MatthewBeddows/COSI-Electronics/Casing/Images/3D view.bmp

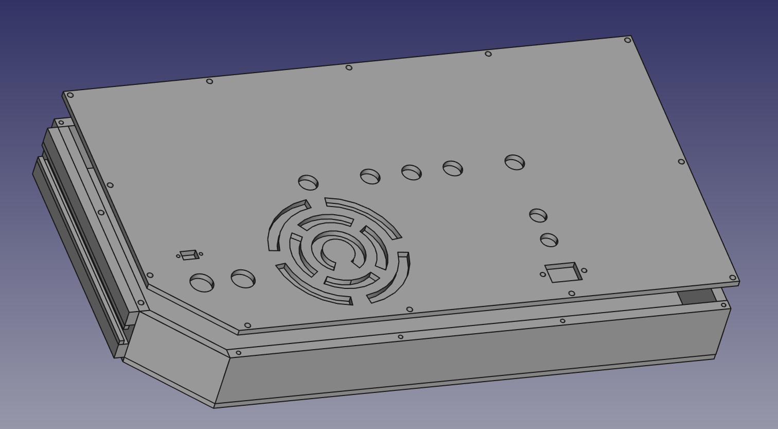
Casing/Images/3D view.bmp
