MatthewBeddows/COSI-Electronics/Casing/Images/back.bmp

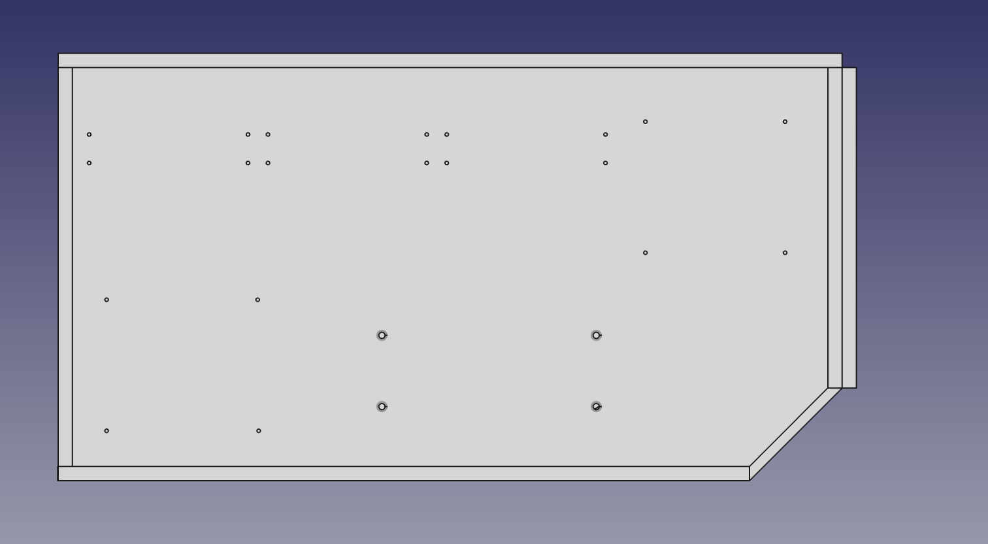
Casing/Images/back.bmp
