MatthewBeddows/COSI-Electronics/Casing/Images/bottom.bmp

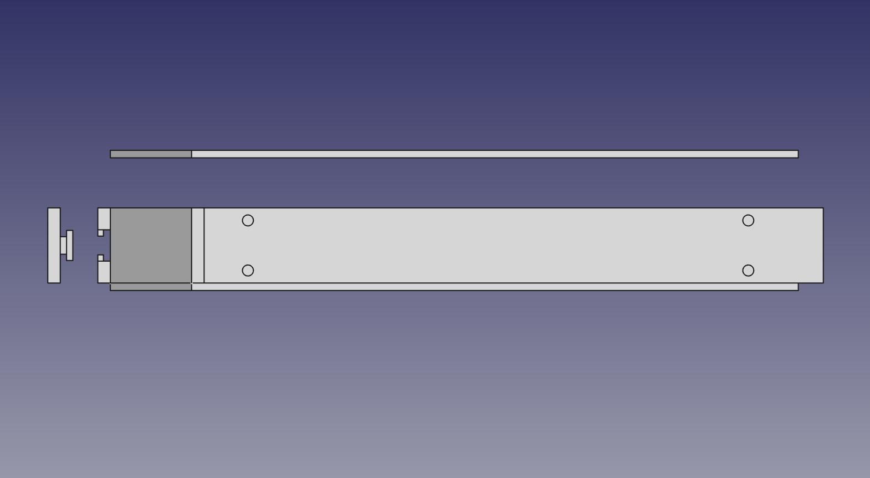
Casing/Images/bottom.bmp
