MatthewBeddows/COSI-Electronics/Casing/Images/front.bmp

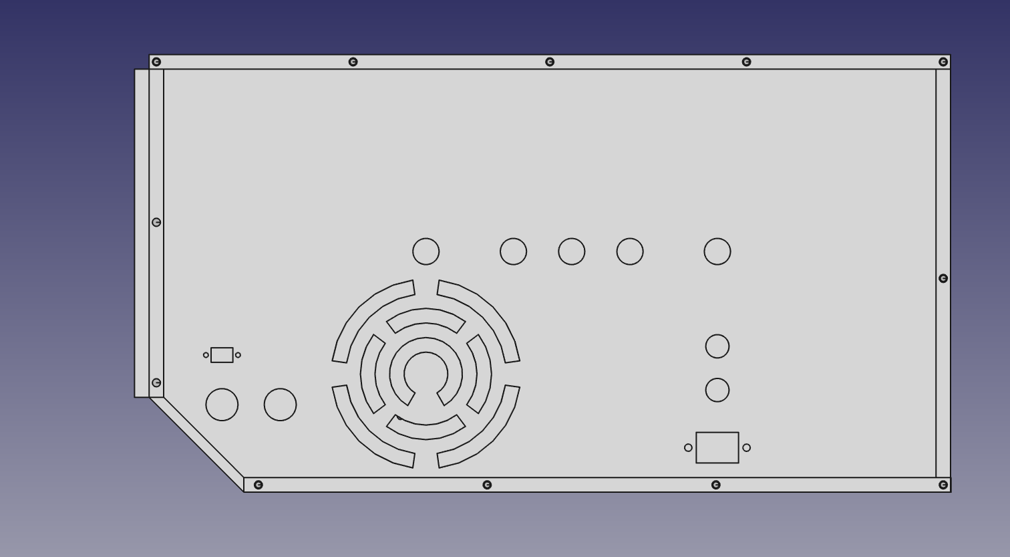
Casing/Images/front.bmp
