MatthewBeddows/COSI-Electronics/Casing/Images/front_noCover.bmp

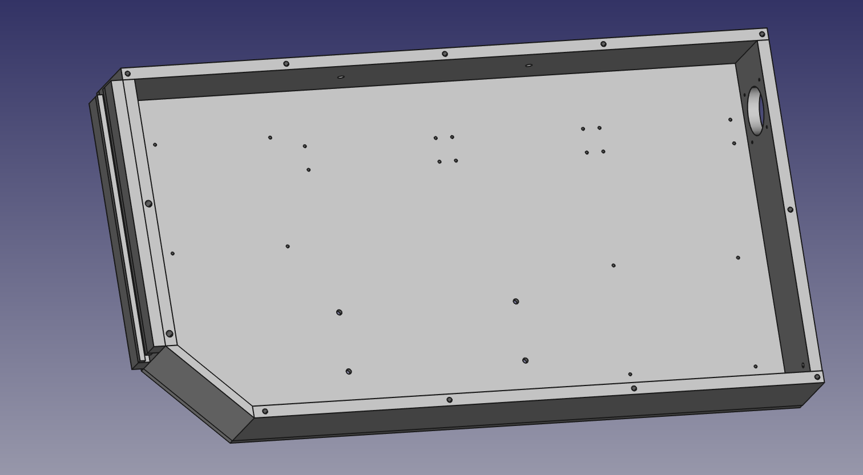
Casing/Images/front_noCover.bmp
