MatthewBeddows/COSI-Electronics/Casing/Images/left.bmp

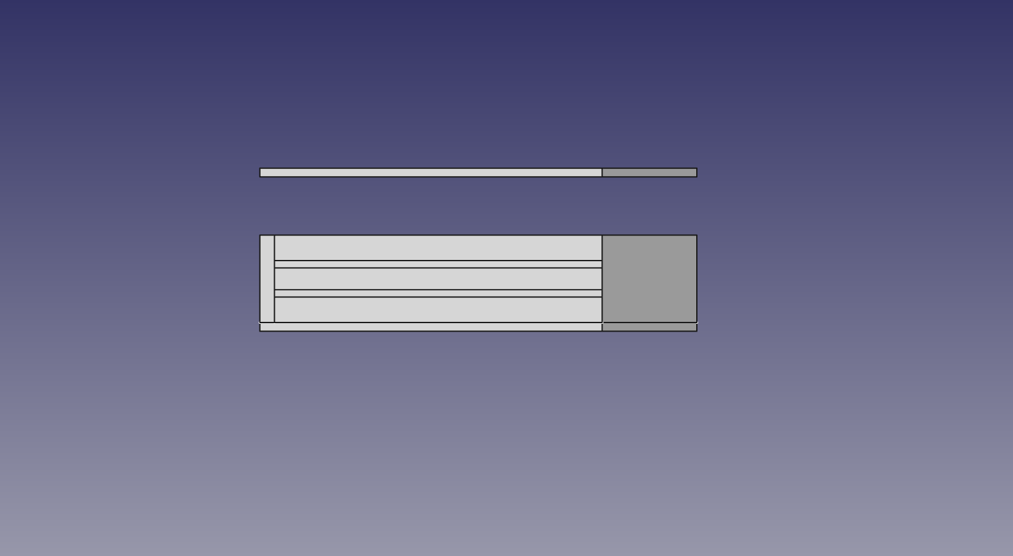
Casing/Images/left.bmp
