MatthewBeddows/COSI-Electronics/Figures/casing_back.jpg

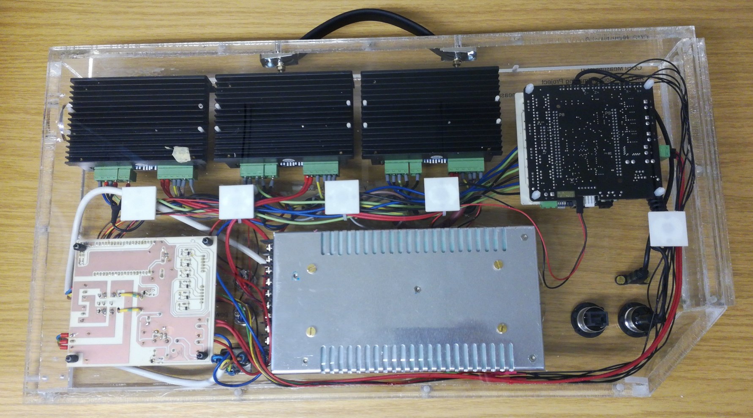
Figures/casing_back.jpg
