MatthewBeddows/COSI-Electronics/Figures/casing_front.jpg

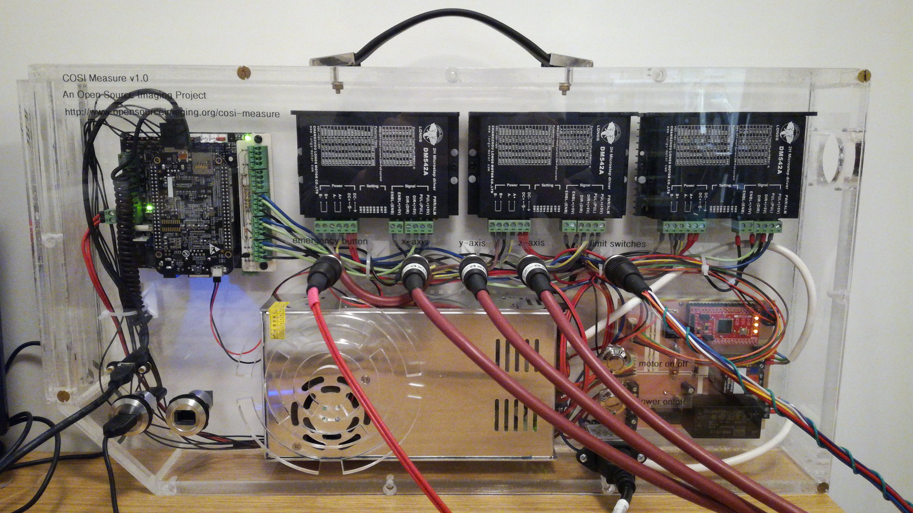
Figures/casing_front.jpg
