MatthewBeddows/COSI-Electronics/J5Bob/FromGithub/Figure1.jpg

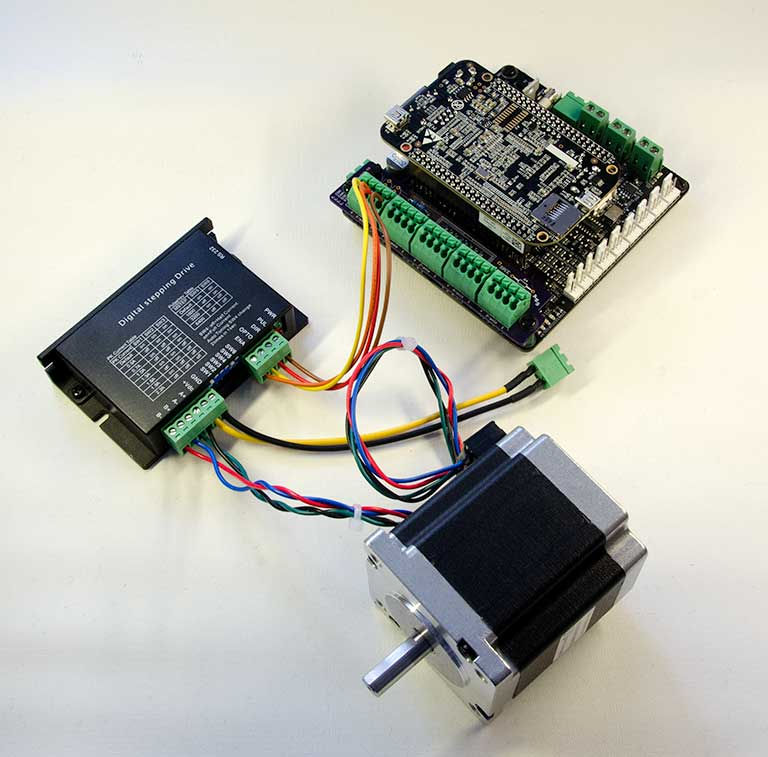
J5Bob/FromGithub/Figure1.jpg
