MatthewBeddows/COSI-Electronics/J5Bob/FromGithub/Figure2.jpg

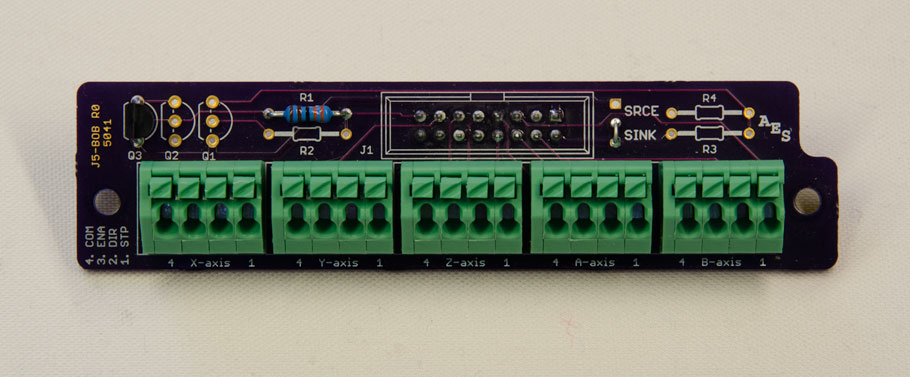
J5Bob/FromGithub/Figure2.jpg
