MatthewBeddows/COSI-Electronics/J5Bob/FromGithub/Figure3.jpg

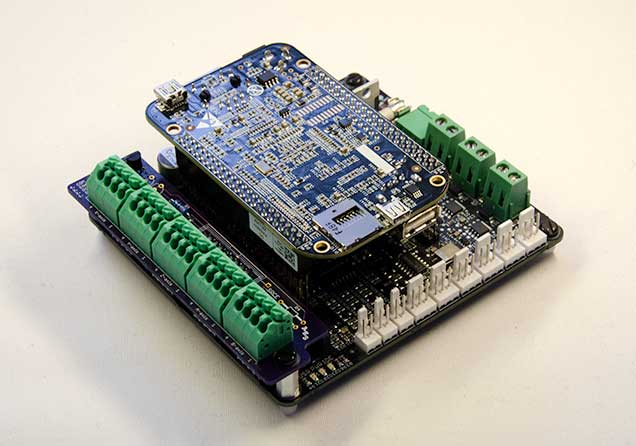
J5Bob/FromGithub/Figure3.jpg
