MatthewBeddows/COSI-Electronics/J5Bob/FromGithub/Figure4.png

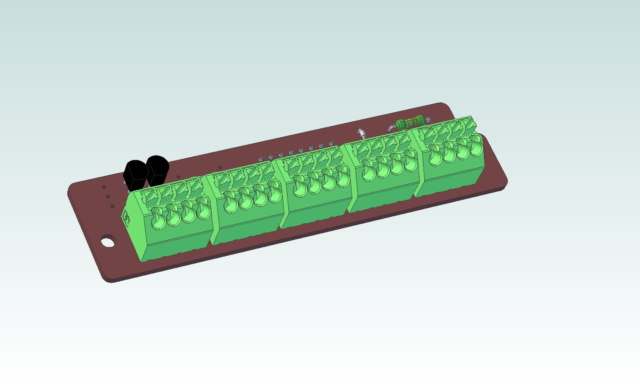
J5Bob/FromGithub/Figure4.png
