MatthewBeddows/COSI-Electronics/2019-03-04_cosi-measure_v1.0_BoM_electronics.ods

Number | Item | Description | Price/Pc [€] | Pcs | Total Price | Comments | Links | Alternative Link
1 | Limit Switches | 4mm 300mA DC6-36V Inductive Proximity Sensor Detection Switch LJ12A3-4-Z/BX | 2,1 | 6 | 12,6 | 5pc package | https://www.roboter-bausatz.de/1477/induktiver-sensor-lj12a3-4-z/bx-dc6-36v?number=RBS11420
2 | male connectors | 6-pole, 6 A 99-0617-00-06 | 5,86 | 3 | 17,58 |  | https://www.conrad.de/de/miniatur-rundsteckverbinder-serie-678-pole-6-kabelstecker-gerade-6-a-99-0617-00-06-binder-1-st-738550.html
3 | male connectors | 8-pole, 5 A 99-0645-00-08 | 9,26 | 1 | 9,26 |  | https://www.conrad.de/de/miniatur-rundsteckverbinder-serie-678-pole-8-kabelstecker-gerade-5-a-99-0645-00-08-binder-1-st-738576.html
4 | Beagle Bone Black | Revision C | 43 | 1 | 43 |  | https://beagleboard.org/black
5 | BeBoPr++ | Beagle Bone extenstion for 3D printer or multiple axes stepper driver control + mating connectors | 92 | 1 | 92 |  | http://elinux.org/BeBoPr%2B%2B | (production of the board is on hold for the moment, but if you are interested in rebuilding COSI Measure and need the capeboard, please contact lukas.winter@opensourceimaging.org)
6 | Stepper motors | 3pcs Nema23, 425 oz.in bipolar single shaft | 206,8 | 1 | 206,8 |  | http://www.ebay.de/itm/German-Ship-3Axis-Nema23-stepper-motor-425oz-in-3A-Schrittmotor-Driver-CNC-kit-/161679851609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
7 | power supply | 3pcs DM542A, Peak 4.2A, 128micsteps | (included in package see no. 6)
8 | motor driver | 1pcs power supply 350W-36vdc/9.7A | (included in package see no. 6)
9 | emergency stop | Ui: 660V; Ith: 10A | 4,62 | 1 | 4,62 |  | https://www.amazon.de/Teken-Mushroom-Emergency-Drukknop-Station/dp/B008LT2VH2
10 | Cable Chain | Igus E14.2.038.0 | 28,52 | 3 | 85,56 |  | https://www.conrad.de/de/energieketteschleppkette-easy-chain-kunststoff-e-kette-e14-e1420380-igus-inhalt-1-st-740324.html
11 | cable | 0.75mm², limit switches + stepper motors | 0,96 | 15 | 14,4 |  | https://www.conrad.de/de/litze-sihf-j-4-x-075-mm-rot-faber-kabel-030710-meterware-1499128.html
12 | Pin strip with wires | Wire-to-board, 2.54mm, 3-pole, limit switches pins at BeBoPr++ | 0,49 | 6 | 2,94 |  | https://www.conrad.de/de/konfektionierte-litze-polzahl-gesamt-3-1244003-rastermass-254-mm-1-st-1568195.html
13 | Pin strip with wires | Wire-to-board, 2.54mm, 2-pole, emergency switch to BeBoPr++ | 1,98 | 1 | 1,98 |  | https://www.conrad.de/de/konfektionierte-litze-polzahl-gesamt-2-741213-rastermass-254-mm-1-st-1570820.html
14 | J5-Bob | Connector extension to BeBePr++, source-enable option |  |  |  |  | https://github.com/modmaker/J5-BOB
 |  | R1 = 3k3 1/4W axial leaded resistor
 |  | Q2 = BC557B or other general purpose PNP transistor
 |  | 5x Phoenix Contact PTSA 1.5/4-3,5-Z
 |  | 2x SIL-8 sockets
Power Management Board
15 | CPLD breakout board | CoolRunner-II XC2C64A CPLD Dev Board | 16,3 | 1 | 16,3 |  | https://www.digikey.de/products/en?mpart=102990004&v=1597
16 | Oscillator | Standard Oscillator --20MHz | 1,48 | 1 | 1,48 |  | https://www.conrad.de/de/quarzoszillator-euroquartz-quarz-oscillator-smd-5x7-smd-hcmos-20000-mhz-7-mm-5-mm-14-mm-155132.html | http://www.mouser.de/ProductDetail/ABRACON/ASV-20000MHZ-EJ-T/?qs=H8AWquzS%2flNowiZ9Nk9Uyw%3d%3d
17 | Pin Connector | Number of pins: 1 x 20 Nominal current: 3 A | 0,29 | 2 | 0,58 |  | https://www.conrad.de/de/w-p-products-stiftleiste-standard-anzahl-reihen-1-polzahl-je-reihe-20-943-13-020-00-1-st-737416.html | http://www.conrad.com/ce/en/product/737416/W-P-Products-943-13-020-00-Multi-Pin-Connector-Number-of-pins-1-x-20-Nominal-current-3-A/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
18 | Socket Connector | Number of pins: 1 x 20 Nominal current: 3 A | 1,49 | 2 | 2,98 |  | https://www.conrad.de/de/w-p-products-buchsenleiste-praezision-anzahl-reihen-1-polzahl-je-reihe-20-153-020-1-50-00-1-st-738335.html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 | http://www.conrad.com/ce/en/product/737416/W-P-Products-943-13-020-00-Multi-Pin-Connector-Number-of-pins-1-x-20-Nominal-current-3-A/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
19 | BSS138 | MOSFET N channel 50V | 0,23 | 8 | 1,84 |  | https://www.conrad.de/de/infineon-technologies-bss138-mosfet-1-n-kanal-360-mw-sot-23-152928.html | http://www.conrad.com/ce/en/product/152928/Infineon-Technologies-BSS138-MOSFET-BSS-138-N-channel-SOT-23-220mA-50V
20 | Resistor | 10 kΩ SMD 0603 0.1 W 1 % 50 ppm MCT 0603 | 0,11 | 16 | 1,76 |  | https://www.conrad.de/de/mct-0603-metallschicht-widerstand-10-k-smd-0603-01-w-1-50-ppm-1-st-475157.html | http://www.conrad.com/ce/en/product/475157/Metal-film-resistor-10-k-SMD-0603-01-W-1-50-ppm-MCT-0603-1-pcs
21 | Resistor | 1 kΩ SMD 0603 0.1 W 1 % 50 ppm MCT 0603 | 0,11 | 4 | 0,44 |  | https://www.conrad.de/de/mct-0603-metallschicht-widerstand-1-k-smd-0603-01-w-1-50-ppm-1-st-474649.html | http://www.conrad.com/ce/en/product/474649/Metal-film-resistor-1-k-SMD-0603-01-W-1-50-ppm-MCT-0603-1-pcs
22 | Relay | G5Q-1-EU 12DC PCB Mount Power Relay 12Vdc 1 CO, SPDT | 3,09 | 1 | 3,09 |  | https://www.conrad.de/de/printrelais-12-vdc-5-a-1-wechsler-omron-g5q-1-eu-12dc-1-st-503931.html | http://www.conrad.com/ce/en/product/503931/Omron-G5Q-1-EU-12DC-PCB-Mount-Power-Relay-12Vdc-1-CO-SPDT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
23 | Pin strip | Number of pins 6; Contact spacing: 2.54 mm | 0,25 | 2 | 0,5 |  | https://www.conrad.de/de/econ-connect-stiftleiste-standard-polzahl-gesamt-6-rastermass-254-mm-psl6g-1-st-1311427.html | http://www.conrad.com/ce/en/product/1311427/Pin-strip-standard-Total-number-of-pins-6-econ-connect-PSL6G-Contact-spacing-254-mm-1-pcs/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
24 | AC/DC PSU | IRM-15-12 12 Vdc 1.25 A 15 W | 6,55 | 1 | 6,55 |  | https://www.conrad.de/de/acdc-printnetzteil-mean-well-irm-15-12-12-vdc-125-a-15-w-1293865.html | http://www.conrad.com/ce/en/product/1293865/ACDC-PSU-print-Mean-Well-IRM-15-12-12-Vdc-125-A-15-W
25 | DC/DC converter | SIM1-1205S-DIL8 12 Vdc 5 Vdc 200 mA 1 W | 4,69 | 1 | 4,69 |  | https://www.conrad.de/de/hn-power-sim1-1205s-dil8-dcdc-wandler-print-12-vdc-5-vdc-200-ma-1-w-anzahl-ausgaenge-1-x-156711.html | http://www.conrad.com/ce/en/product/156711/DCDC-converter-print-HN-Power-SIM1-1205S-DIL8-12-Vdc-5-Vdc-200-mA-1-W-No-of-outputs-1-x
26 | Inductor | Axial lead 12 µH 48 mΩ | 0,72 | 1 | 0,72 |  | https://www.conrad.de/de/fastron-mesc-120m-01-induktivitaet-axial-bedrahtet-12-h-0048-4-a-1-st-440178.html | http://www.conrad.com/ce/en/product/440178/Inductor-Axial-lead-12-H-48-m-Fastron-MESC-120M-01-1-pcs
27 | Ceramic capacitor | SMD 0805 4.7 µF 25 V 10 % | 0,29 | 2 | 0,58 |  | https://www.conrad.de/de/keramik-kondensator-smd-0805-47-f-25-v-10-l-x-b-x-h-2-x-05-x-125-mm-kemet-c0805c475k3pac7800-1-st-1420400.html | http://www.conrad.com/ce/en/product/1420400/Ceramic-capacitor-SMD-0805-47-F-25-V-10-L-x-W-x-H-2-x-05-x-125-mm-Kemet-1-pcs
28 | Ceramic capacitor | SMD 0805 0.1 µF 25 V 10 % | 0,07 | 2 | 0,14 |  | https://www.conrad.de/de/keramik-kondensator-smd-0805-01-f-25-v-10-yageo-cc0805krx7r8bb104-1-st-445198.html | http://www.conrad.com/ce/en/product/445198/Ceramic-capacitor-SMD-0805-01-F-25-V-10-Yageo-CC0805KRX7R8BB104-1-pcs
29 | Electrolytic capacitor | Radial lead 2.5 mm 100 µF 25 Vdc 20 % | 0,14 | 2 | 0,28 |  | https://www.conrad.de/de/panasonic-eeufc1e101s-elektrolyt-kondensator-radial-bedrahtet-25-mm-100-f-25-vdc-20-o-x-h-63-mm-x-112-mm-1-st-421945.html | http://www.conrad.com/ce/en/product/421945/Electrolytic-capacitor-Radial-lead-25-mm-100-F-25-Vdc-20--x-H-63-mm-x-112-mm-Panasonic-EEUFC1E101S-1-pcs
30 | Pin connector | Contact spacing: 2.54 mm Total number of pins: 4 | 0,52 | 1 | 0,52 |  | https://www.conrad.de/de/pfosten-steckverbinder-rastermass-254-mm-polzahl-gesamt-4-anzahl-reihen-2-fci-1-st-1401800.html | http://www.conrad.com/ce/en/product/1401800/Pin-connector-Contact-spacing-254-mm-Total-number-of-pins-4-FCI-1-pcs
31 | Diode | 1N4004 | 0,13 | 2 | 0,26 |  | https://www.conrad.de/de/si-gleichrichterdiode-diotec-1n4004-do-204al-400-v-1-a-162248.html?altOf=AN | http://www.conrad.com/ce/en/product/1262763/Diode-Fairchild-Semiconductor?ref=searchDetail
32 | Relay | TE Connectivity PT370012 | 12,99 | 1 | 12,99 |  | https://www.conrad.de/de/printrelais-12-vdc-10-a-3-wechsler-te-connectivity-pt370012-1-st-503974.html | http://www.conrad.com/ce/en/product/503974/TE-Connectivity-PT370012-PCB-Mount-Relay-12Vdc-10A-3-CO-3PDT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
33 | Screw terminal | 1.50 mm² Number of pins 3 AK500/3DS-5.0-V PTR | 0,33 | 3 | 0,99 |  | https://www.conrad.de/de/ptr-ak5003ds-50-v-schraubklemmblock-150-mm-polzahl-3-grau-1-st-729957.html | http://www.conrad.com/ce/en/product/729957/PTR-50500030121G-3-Way-PCB-Screw-Terminal-Block-50mm-175-A-15-A-Grey
34 | Screw terminal | 1.50 mm² Number of pins 2 AK500/2DS-5.0-V PTR | 0,27 | 3 | 0,81 |  | https://www.conrad.de/de/ptr-ak5002ds-50-v-schraubklemmblock-150-mm-polzahl-2-grau-1-st-729949.html | http://www.conrad.com/ce/en/product/729949/PTR-50500020121G-2-Way-PCB-Screw-Terminal-Block-50mm-175-A-15-A-Grey
35 | Pin strip mate with wires | Number of pins 6; Contact spacing: 2.54 mm | 1,29 | 2 | 2,58 |  | https://www.conrad.de/de/econ-connect-steckbuchse-mit-litze-polzahl-gesamt-6-rastermass-254-mm-ps6-1-st-1303863.html | http://www.conrad.com/ce/en/product/1303863/Receptacle-braid-Total-number-of-pins-6-econ-connect-PS6-Contact-spacing-254-mm-1-pcs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
 |  | Total cost electrical subsystem: | 550,82
Optional
36 | HDMI adapter | HDMI - HDMI Micro | 13,99 | 1 | 13,99 |  | https://www.conrad.com/ce/en/product/1373669/HDMI-Adapter-1x-HDMI-socket-D-Micro-1x-HDMI-socket-Black-gold-plated-connectors-SpeaKa-Professional
37 | Monitor | ASUS VT168H 15,6" Touchscreen | 140,29 | 1 | 140,29 |  | https://www.conrad.de/de/asus-vt168h-touchscreen-monitor-396-cm-156-zoll-eek-a-1366-x-768-pixel-hd-5-ms-hdmi-vga-usb-tn-lcd-1661358.html
38 | JTAG programmer | Digilent JTAG-HS3 | 80,52 | 1 | 80,52 |  | https://www.conrad.de/de/programmierer-digilent-210-299-1526938.html
39 | USB Hub | 4 ports USB 2.0 | 7,99 | 1 | 7,99 |  | http://www.conrad.com/ce/en/product/986337/4-ports-USB-20-hub-LogiLink-Black?queryFromSuggest=true
40 | Mouse
41 | Keyboard
 |  | Total cost assecoires: | 242,79
Extension Cable (optional)
42 | male connectors | 6-pole, 6 A 99-0617-00-06 | 5,86 | 3 | 17,58 |  | https://www.conrad.de/de/miniatur-rundsteckverbinder-serie-678-pole-6-kabelstecker-gerade-6-a-99-0617-00-06-binder-1-st-738550.html
43 | female connectors | 6-pole, 6 A 99-0618-00-06 | 7,1 | 3 | 21,3 |  | https://www.conrad.de/de/miniatur-rundsteckverbinder-serie-678-pole-6-kabeldose-gerade-6-a-99-0618-00-06-binder-1-st-738627.html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
44 | cable | LiYCY 4x0.75mm² | 4,3 | 6 | 25,8 |  | https://www.conrad.de/de/lappkabel-oelflex-classic-110-cy-steuerleitung-7-g-075-mm-transparent-1135107-meterware-601918.html
45 | male connectors | 8-pole, 5 A 99-0645-00-08 | 9,26 | 1 | 9,26 |  | https://www.conrad.de/de/miniatur-rundsteckverbinder-serie-678-pole-8-kabelstecker-gerade-5-a-99-0645-00-08-binder-1-st-738576.html
46 | female connectors | 8-pole, 5 A 99-0646-00-08 | 11,56 | 1 | 11,56 |  | https://www.conrad.de/de/miniatur-rundsteckverbinder-serie-678-pole-8-kabeldose-gerade-5-a-99-0646-00-08-binder-1-st-738653.html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
47 | cable | LIYCY 08x0.5mm² GR | 2,32 | 2 | 4,64 |  | https://www.conrad.de/de/steuerleitung-liycy-8-x-05-mm-grau-faber-kabel-030883-meterware-1152496.html
 |  | Total cost extenstion cable: | 90,14
Casing
48 | power socket + filter | 250V, 6A, YB06T1 | 7,69 | 1 | 7,69 |  | https://www.conrad.de/de/yunpen-yb06t1-netzfilter-mit-kaltgeraetebuchse-250-vac-6-a-07-mh-l-x-b-x-h-57-x-2525-x-523-mm-1-st-515051.html
49 | USB socket | USB 3.0 | 18,04 | 1 | 18,04 | cheaper ones available and 3.0 not necessary, but looks good :) | https://www.conrad.de/de/usb-einbaubuchse-30-usb-08-tru-components-inhalt-1-st-1243946.html
50 | HDMI socket + cable | Micro HDMI Male to Female, panel mount, 30cm | 8,93 | 1 | 8,93 |  | https://www.amazon.de/gp/product/B00HFFXXCA/ref=oh_aui_detailpage_o01_s00?ie=UTF8&psc=1 | https://www.conrad.de/de/inline-hdmi-4k2k-adapterkabel-zum-einbau-hdmi-a-steckerbuchse-06m-800407139.html
51 | RJ45 socket |  | 14,96 | 1 | 14,96 |  | https://www.conrad.de/de/rj-einbaubuchse-buchse-einbau-rj45-02-silber-tru-components-1417396-1-st-1417396.html
52 | RJ45 cable | 0.25m, flexible | 4,95 | 1 | 4,95 |  | https://www.elv.de/ttl-network-patchkabel-ultra-flex-cat-6a-blaugrau-0-25-m.html
53 | Socket female | 3 poles, for emergency button | 3,52 | 1 | 3,52 |  | https://www.conrad.de/de/binder-99-0608-00-03-rundstecker-flanschstecker-serie-rundsteckverbinder-678-gesamtpolzahl-3-1-st-738745.html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
54 | Connector | 3 poles, for emergency button | 6,11 | 1 | 6,11 |  | https://www.conrad.de/de/binder-99-0605-00-03-rundstecker-stecker-gerade-serie-rundsteckverbinder-678-gesamtpolzahl-3-1-st-738914.html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
55 | Push button | Power On/Off, momentary SPST | 4,03 | 1 | 4,03 |  | https://www.conrad.de/de/tru-components-gq-16f-n-vandalismusgeschuetzter-drucktaster-48-vdc-2-a-1-x-ausein-ip65-tastend-1-st-701274.html
56 | Push button | Motor power ON/OFF, momentary SPST | 4,03 | 1 | 4,03 |  | https://www.conrad.de/de/tru-components-gq-16f-n-vandalismusgeschuetzter-drucktaster-48-vdc-2-a-1-x-ausein-ip65-tastend-1-st-701274.html
57 | Socket female | 6-pole, Stepper motors | 4,1 | 3 | 12,3 |  | https://www.conrad.de/de/binder-99-000-06-rundstecker-flanschstecker-serie-rundsteckverbinder-678-gesamtpolzahl-6-1-st-738783.html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
58 | Socket female | 8-pole, Limit switches | 9,24 | 1 | 9,24 |  | https://www.conrad.de/de/binder-99-0648-00-08-rundstecker-flanschstecker-serie-rundsteckverbinder-678-gesamtpolzahl-8-1-st-738809.html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
59 | Distance holders | M3 inner/outer, 10mm | 0,34 | 8 | 2,72 |  | https://www.conrad.de/de/abstandsbolzen-aussen-und-innengewinde-m3-polyamid-abstandsmass-10-mm-1-st-bulk-534749.html
60 | Screws | M3x6, power board + BeBePr++ mount, power socket | 0,01 | 8 | 0,08 | 100pc package | https://www.conrad.de/de/toolcraft-815322-linsenschrauben-m3-6-mm-kreuzschlitz-phillips-din-7985-stahl-galvanisch-verzinkt-100-st-815322.html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
61 | Screws | M4x10, countersunk, power supply mount | 0,014 | 4 | 0,056 | 200pc package | https://www.reichelt.de/flach-senkkopfschrauben-schlitz-m4-10-mm-ssk-m4x10-200-p65739.html?r=1
62 | Screws | M3x15, driver mount | 0,16 | 12 | 1,92 | 10pc package | https://www.conrad.de/de/toolcraft-815810-zylinderschrauben-m3-15-mm-schlitz-din-84-iso-1207-kunststoff-polyamid-10-st-815810.html
63 | Handle |  | 3,4 | 1 | 3,4 |  | https://www.conrad.de/de/tragegriff-schwarz-l-x-b-x-h-195-x-235-x-8-mm-mentor-32481001-1-st-183329.html
64 | Screws | M5x22, for handle | 0,136 | 2 | 0,272 | 200pc package | https://www.conrad.de/de/toolcraft-to-5445168-zylinderschrauben-m5-22-mm-schlitz-din-84-messing-200-st-1815056.html
65 | Nuts | M5, for handle | 0,045 | 2 | 0,09 | 100pc package | https://www.conrad.de/de/toolcraft-1066569-sicherungsmuttern-m5-din-982-edelstahl-a4-100-st-1066569.html
66 | Washer | M5, for handle | 0,0134 | 2 | 0,0268 | 100pc package | https://www.conrad.de/de/toolcraft-814687-unterlegscheiben-innen-durchmesser-53-mm-m5-din-125-stahl-verzinkt-100-st-814687.html
67 | Screws | M8x20, countersunk, to aluminum frame | 0,3 | 8 | 2,4 |  | https://www.dold-mechatronik.de/DIN-7991-Senkschraube-mit-Innensechskant-88-verzinkt
68 | Sliding nuts | I-Typ Nut8, M8, mount aluminum frame | 0,37 | 8 | 2,96 | 10pc package | https://www.dold-mechatronik.de/Nutenstein-mit-Steg-I-Typ-Nut-8-Gewindedurchmesser-waehlbar
69 | Casing material | e.g. Acrylic glas, laser cut (see tech drawings/CAD files/docu)
70 | Screws | M5x10, countersunk, front cover mount |  | 12
71 | Screws | M5x15, fixing casing to frame |  | 2
72 | Blade receptacle | 6.3mm | 0,26 | 2 | 0,52 |  | https://www.conrad.de/de/tru-components-1582963-flachsteckhuelse-steckbreite-630-mm-steckdicke-080-mm-180-teilisoliert-blau-1-st-1582963.html
73 | Wire end ferrules | 0.75mm² | 0,013 | 45 | 0,585 | 1000pc package | https://www.conrad.de/de/1213200-phoenix-contact-aderendhuelse-1-x-075-mm-x-8-mm-teilisoliert-blau-1000-st-1833124.html
74 | Mounting base |  | 0,91 | 5 | 4,55 |  | https://www.conrad.de/de/hellermanntyton-151-28469-mb4a-pa66-na-c1-befestigungssockel-selbstklebend-schraubbar-4fach-einfaedeln-halogenfrei-uv-541796.html
75 | USB cable | USB 2.0 | 5,03 | 1 | 5,03 |  | https://www.conrad.de/de/delock-usb-20-anschlusskabel-1x-usb-20-stecker-a-1x-usb-20-stecker-a-06-m-schwarz-spiralkabel-398990.html
76 | Screws | M4x6, HDMI socket | 0,021 | 2 | 0,042 | 200pc package | https://www.conrad.de/de/toolcraft-145918-linsenschrauben-m4-6-mm-kreuzschlitz-phillips-din-7985-stahl-galvanisch-verzinkt-200-st-145918.html
 |  | Total cost casing: | 118,4518
