MatthewBeddows/COSI-Electronics/doc/GitBuilding/models/casing_assembled_withMountingParts.stl

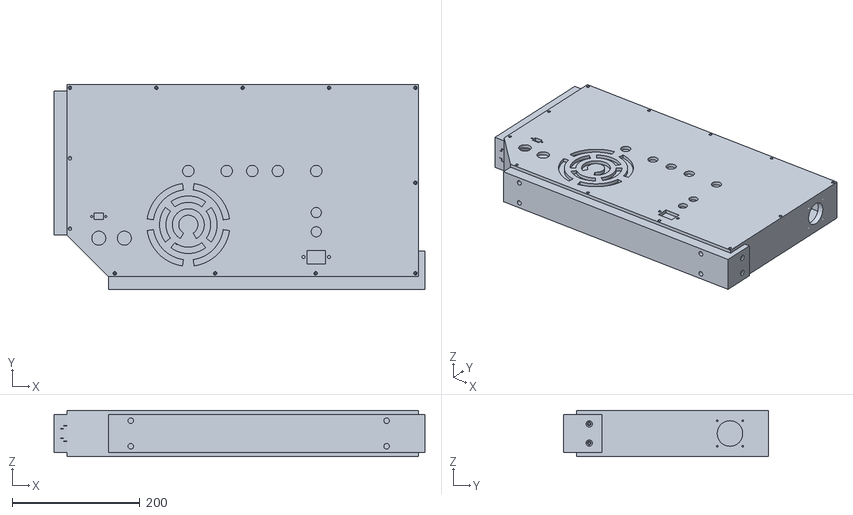
[picture p25: CAD file, 2024-10-09]
doc/GitBuilding/models/casing_assembled_withMountingParts.stl
580.0 x 320.0 x 72.0
