MatthewBeddows/COSI-Electronics/Casing/STL/casing_assembled_withoutMountingParts.stl

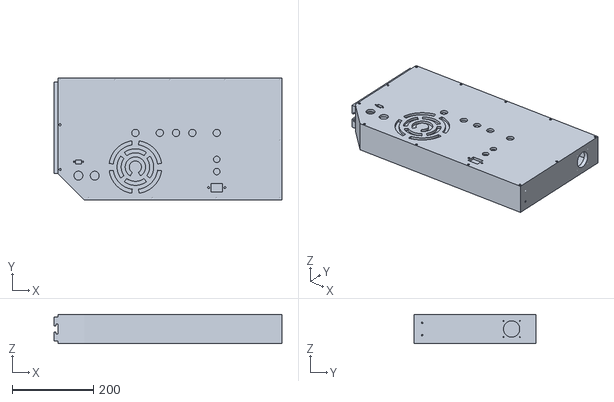
[picture p26: CAD file, 2024-10-09]
Casing/STL/casing_assembled_withoutMountingParts.stl
560.3 x 300.0 x 72.0
