MatthewBeddows/COSI-Electronics/Casing/2018-11-11_cosi-measure-v1.0_casing.FCStd

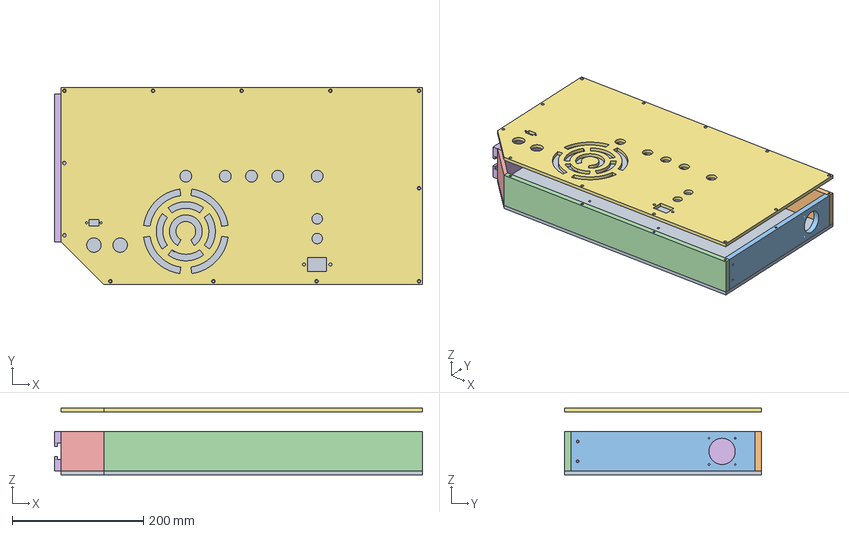
[picture p27: CAD file, 2024-10-09]
Casing/2018-11-11_cosi-measure-v1.0_casing.FCStd
560.3 x 300.0 x 102.0 mm
Baseplate
Top
Right
Bottom
Corner
Left side
Front Cover
