MatthewBeddows/COSI-Electronics/Casing/STL/part5_bottom.stl

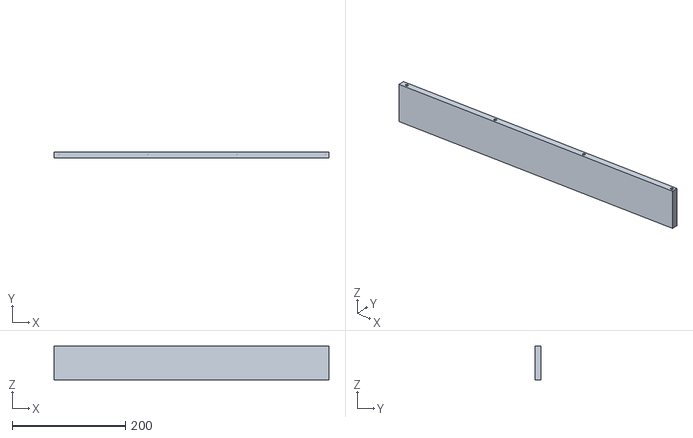
[picture p28: CAD file, 2024-10-09]
Casing/STL/part5_bottom.stl
485.3 x 10.0 x 60.0
