MatthewBeddows/COSI-Electronics/Casing/STL/part1_baseplate.stl

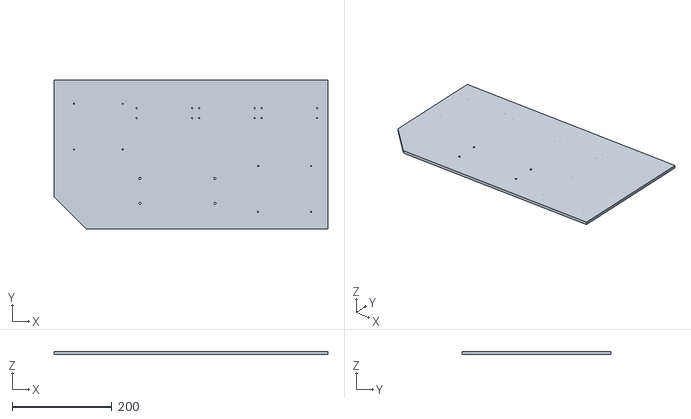
[picture p29: CAD file, 2024-10-09]
Casing/STL/part1_baseplate.stl
550.0 x 300.0 x 6.00
