MatthewBeddows/COSI-Electronics/Casing/STL/part8_mountX.stl

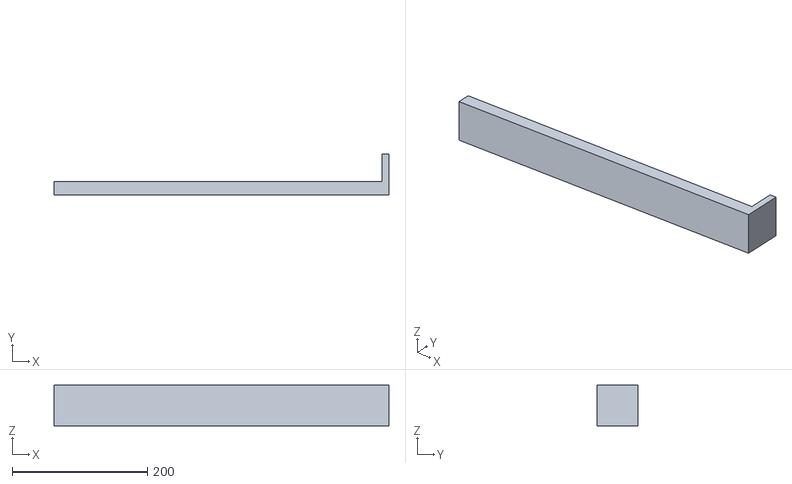
[picture p30: CAD file, 2024-10-09]
Casing/STL/part8_mountX.stl
495.0 x 60.0 x 60.0
