MatthewBeddows/COSI-Electronics/Casing/STL/part6_front.stl

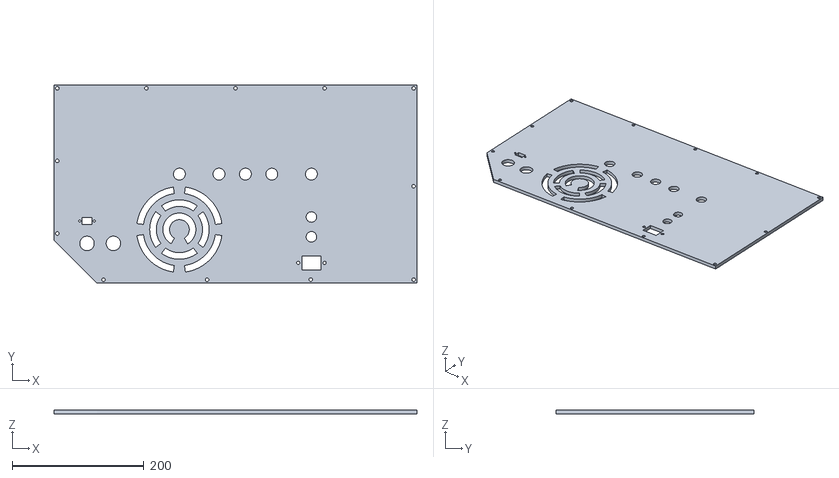
[picture p31: CAD file, 2024-10-09]
Casing/STL/part6_front.stl
550.0 x 300.0 x 6.00
