MatthewBeddows/COSI-Electronics/Casing/STL/part3_right.stl

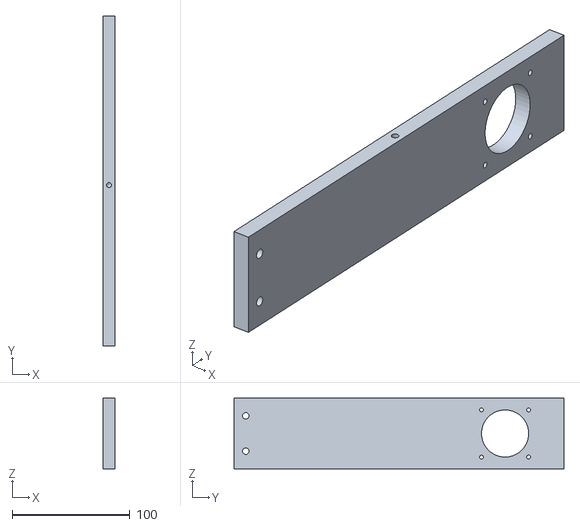
[picture p32: CAD file, 2024-10-09]
Casing/STL/part3_right.stl
10.0 x 280.0 x 60.0
