MatthewBeddows/COSI-Electronics/Casing/STL/part4_top.stl

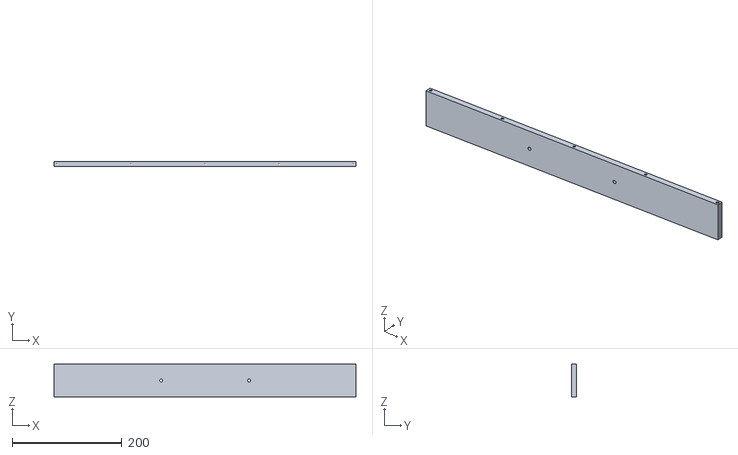
[picture p33: CAD file, 2024-10-09]
Casing/STL/part4_top.stl
549.5 x 10.0 x 60.0
