MatthewBeddows/COSI-Electronics/Casing/STL/part7_mountZ.stl

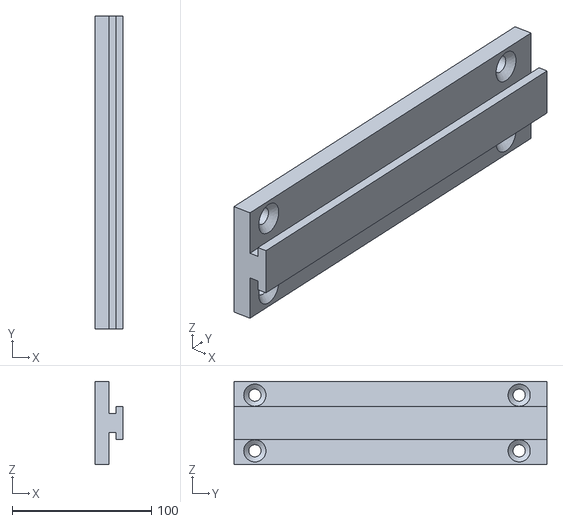
[picture p34: CAD file, 2024-10-09]
Casing/STL/part7_mountZ.stl
20.0 x 225.0 x 60.0
