MatthewBeddows/COSI-Electronics/Casing/STL/part2_left.stl

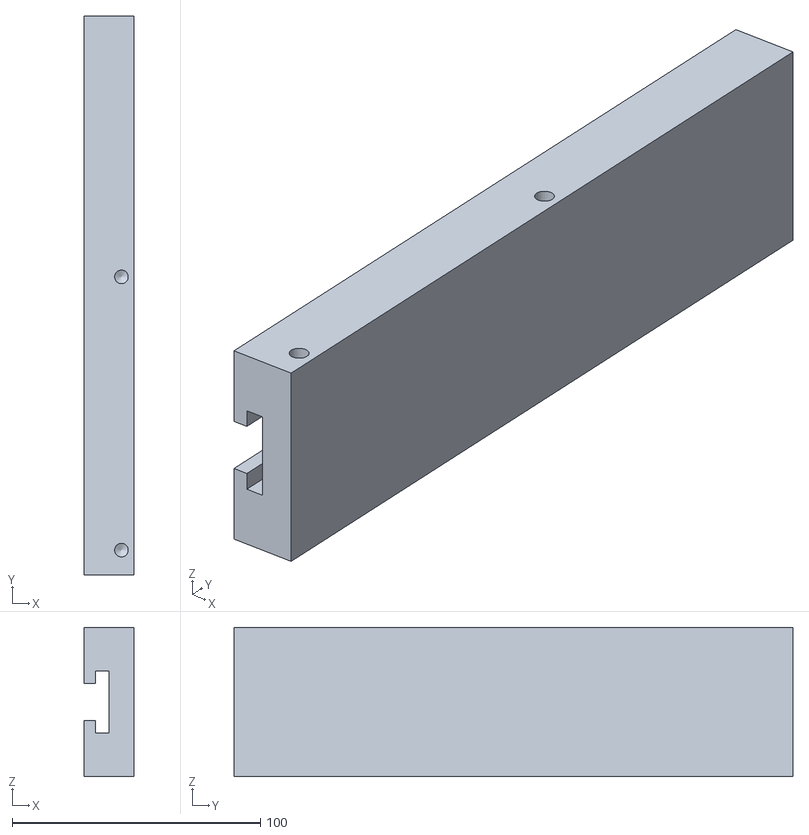
[picture p35: CAD file, 2024-10-09]
Casing/STL/part2_left.stl
20.0 x 225.0 x 60.0
