MatthewBeddows/COSI-Electronics/Casing/STL/part9_corner.stl

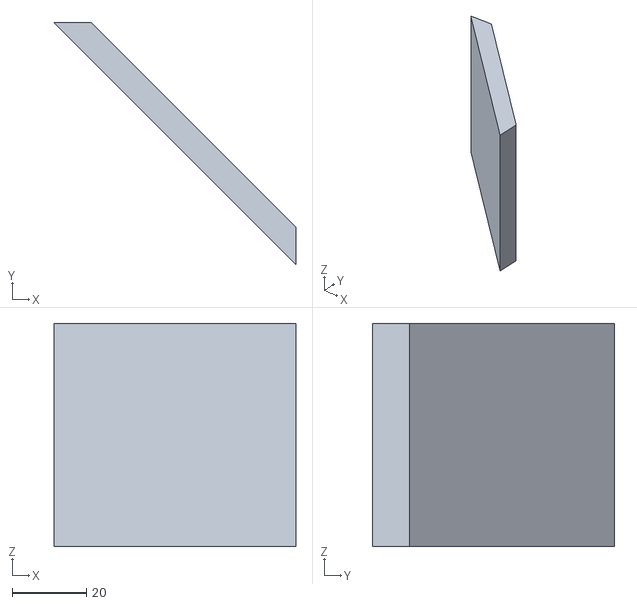
[picture p36: CAD file, 2024-10-09]
Casing/STL/part9_corner.stl
65.0 x 65.0 x 60.0
