MatthewBeddows/COSI-Electronics/Casing/2019-01-11_cosi-measure_v1.0_casing_assembly_instructions.pdf

## COSI-Measure v1.0

## Mechanical Casing Assembly

Revision History

Rev. | Date (YYYY-MM-DD) | Description of Change | Author/ Contributors
1.0 | 2019-01-11 | Initial version | Lukas Winter

Notes:

●

ABOUT

Please find below the assembly documentation for COSI measure a 3D multipurpose measurement system. If you find any flaws or if you have any questions/suggestions with regards to this document or project please let us know l ukas.winter@ptb.de. Improving the quality of this work and its documentation makes it easier for others to reproduce and build upon this work.

Documentation published describing Hardware is licensed under the CERN OHL v. 1.2. You may redistribute and modify this documentation under the terms of the CERN OHL v.1.2. (http://ohwr.org/cernohl) except otherwise stated.

This documentation is distributed WITHOUT ANY EXPRESS OR IMPLIED WARRANTY, INCLUDING OF MERCHANTABILITY, SATISFACTORY QUALITY AND FITNESS FOR A PARTICULAR PURPOSE. Please see the CERN OHL v.1.2 for applicable conditions.

If you find COSI measure useful in your work, please cite this paper:

Han H, Moritz R, Oberacker E, Waiczies H, Niendorf T and Winter L, „Open Source 3D Multipurpose Measurement System with Submillimetre Fidelity and First Application in Magnetic Resonance“, Scientific Reports, 7:13452, 2017

Introduction

This document describes the mechanical assembly of the COSI Measure casing. The partlist for the casing can be found in the electronics bill of material (BoM) v1.0 file.

A more detailed description of COSI Measure can be found here: http://www.opensourceimaging.org/project/cosi-measure/

and here:

Han H, Moritz R, Oberacker E, Waiczies H, Niendorf T and Winter L, „Open Source 3D Multipurpose Measurement System with Submillimetre Fidelity and First Application in Magnetic Resonance“, Scientific Reports, 7:13452, 2017


Figure 1 Photograph of the assembled casing and hardware.

Useful tools:

- Glue (e.g. Acrifix)
- Screw clamps (optional)
- File

1. Prepare casing material

Components needed:

Quantitiy | Part description | Number (BoM) | Comment
1 | Casing material | 69

We have created a 3D CAD model of the casing with FreeCAD (Figure 2). The casing consists of 9 overall parts, which can be fabricated e.g. from Acrylic glas (we used transparent acrylic glas for educational purposes, to highlight the open source nature of the project and to see all the status LEDs from the individual hardware components). For our purposes we have used a laser cutter to fabricate all components based on scalable vector graphics (.SVG) files extracted from the FreeCAD model. Alternatively technical drawings (PDF) are available that display all features of the casing.
A visual overview of all parts is provided in partnumber_overview.pdf (Figure 2-3).

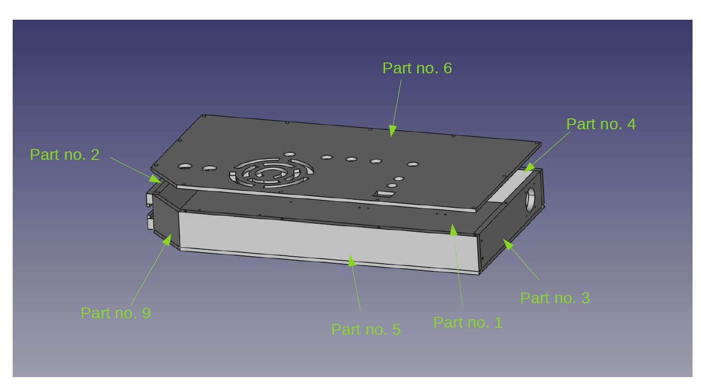
[picture p65: figure]
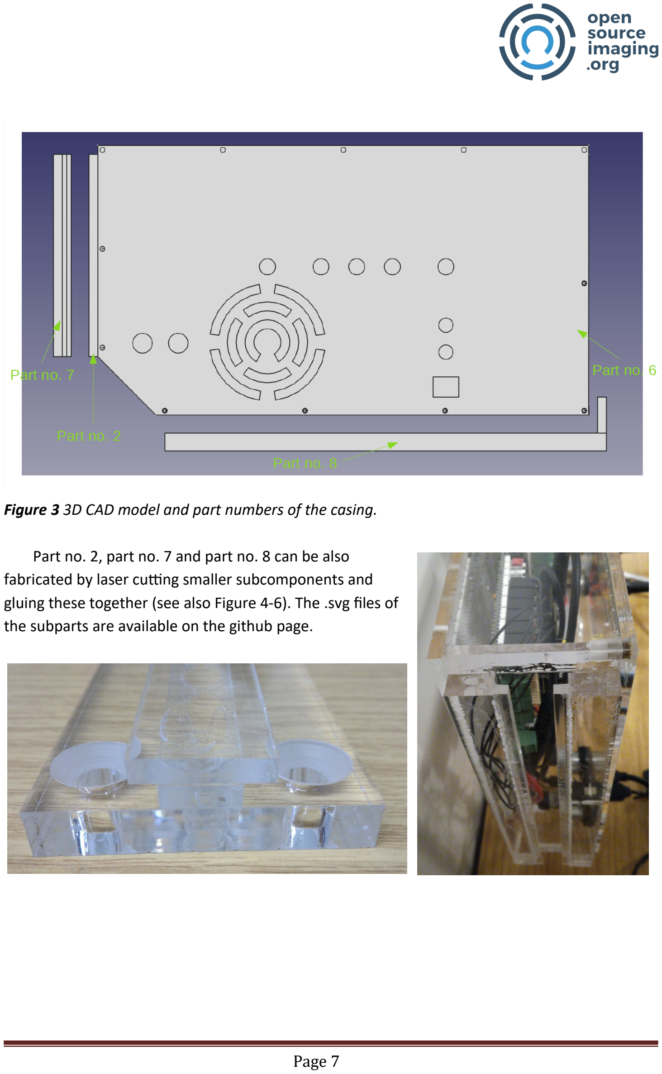
[picture p66: page 7]

Part no. 2, part no. 7 and part no. 8 can be also fabricated by laser cutting smaller subcomponents and gluing these together (see also Figure 4-6). The .svg files of the subparts are available on the github page.

Figure 3 3D CAD model and part numbers of the casing.

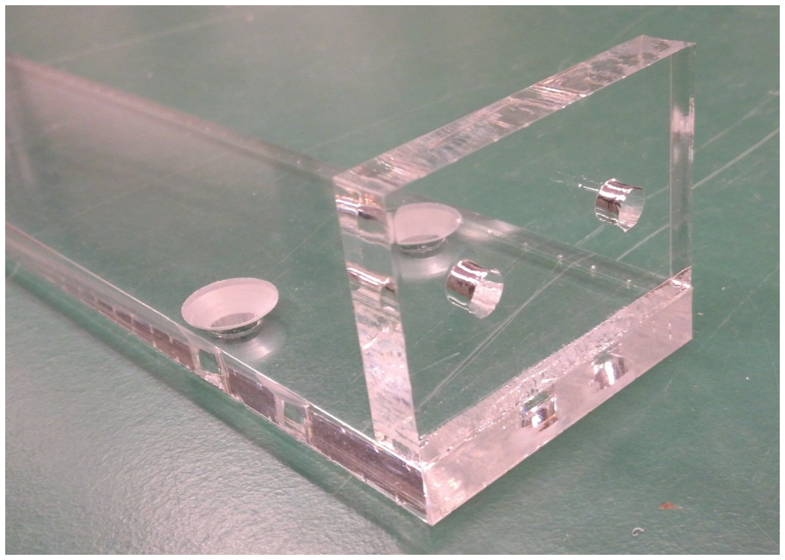
[picture p67: figure]

Functionality of the casing:
Part no. 7 can be mounted to the z-axis and part no. 8 can be mounted to the x-axis of the COSI-Measure aluminum frame. In this configuration it is possible to slide the hardware casing via part no.2 into part no. 7. There are two small screws that connect part no. 8 and part no. 3 to stabilize the casing in this position. As such the hardware is fixed to the mechanical part of COSI-Measure and does not require extra space. If needed the casing can be removed e.g. if the measurement setup requires that (e.g. space constraints, electrical noise etc.) or e.g. to use the electronics in a different experimental setup where stepper motor drivers are needed. In order to remove the casing only the two screws (part no. 8) have to be removed and the casing can slide out.
The Open Source Imaging Logo in the front cover (part no. 6) is located directly above the power supply. It is for air circulation inside the casing. A simpler geometry (simple holes) can be used in case a laser cutter or similar is not available to cut out this “complex” shape.

2. Assembly of the baseplate

Components needed:

Quantitiy | Part description | Number (BoM) | Comment
1 | Part no.1 | - | Baseplate
1 | Part no. 2 | - | Left
1 | Part no. 3 | - | Right
1 | Part no. 4 | - | Top
1 | Part no. 5 | - | Bottom
1 | Glue | - | For Acryl e.g. Acrifix
2.1. Glue parts no. 2-5 to the baseplate (part no. 1) as shown in Figure 7 (The threaded holes should be pointing up so that the front cover can be later on screwed to them). Depending on your material you’ll need to select an appropriate glue. We have used Acrylic Glas as a casing material and Acrifix as an adhesive. In order to hold the parts in place until the glue drys, screw clamps can help. Make sure to glue the parts accurately, otherwise the holes in the cover might not be overlapping properly and it will be difficult to close the casing.

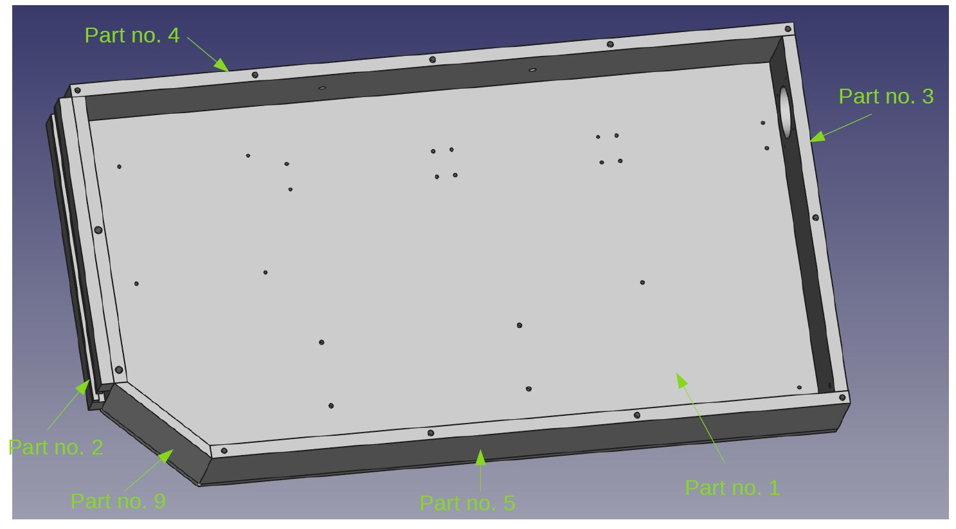
[picture p68: figure]

Figure 7 3D CAD view of the baseplate mounted with parts 2-5.

3. Frontcover sockets
3.1. For the sockets in the casing a locking groove is needed for the 3-pole, the 8-pole and the three 6-pole sockets. If can be easily made using a small file (Figure 8) if a laser cutter is not available.

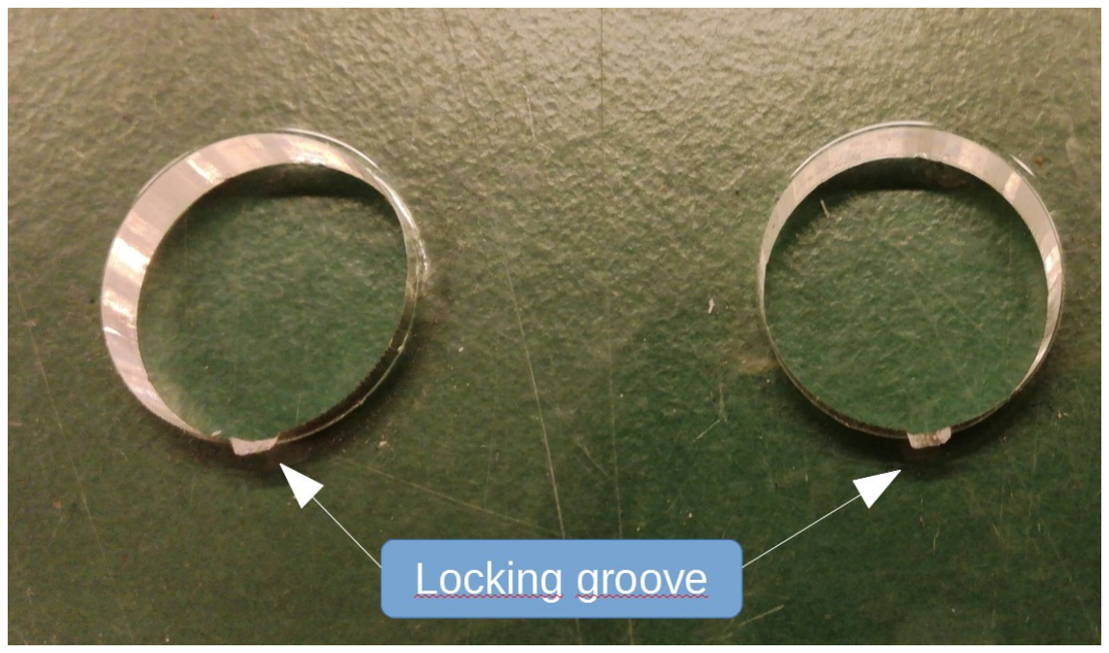
[picture p69: figure]

### 4. Mount the handle

Components needed:

Quantitiy | Part description | Number (BoM) | Comment
1 | Handle | 63
2 | Screws M5x22 | 64
2 | Nuts M5 | 65
2 | Washer M5 | 66
1 | Assembled casing (see step 2) | - | -
4.1. Mount the handle using all components to part no. 4 of the assembled casing.

### 5. Functional tests

5.1. Test if part No. 7 can easily slide through part no. 2.
5.2. Test if the cover can be screwed to the finished baseplate.
5.3. Test if part no. 8 can easily be screwed to part no. 3.
5.4. Test if the locking grooves sufficiently lock the sockets.

## Comments

Here we are collecting a list of issues and improvements. If you found any errors in the documentation, have ideas/suggestions for improvements or if you did some modifications, please let us know (you can edit this document with the tracking function and send it to us).

Issues/Improvements (minor)
- M5 countersunk screws are slightly too big for an acrylic cover. Better using M4 or M3 or no countersink.
- Locking grooves are not included yet in the 3D CAD model and other files (e.g. SVG). Can be easily added later on using a file (see step 3 of this document)
- In the svg file of the front cover a hole is missing of the power socket (exporting bug FreeCAD?). Can be easily drilled later on.
