MatthewBeddows/COSI-Electronics/J5Bob/J5-Bob_source-enable_assembly_for_COSI-Measure.jpg

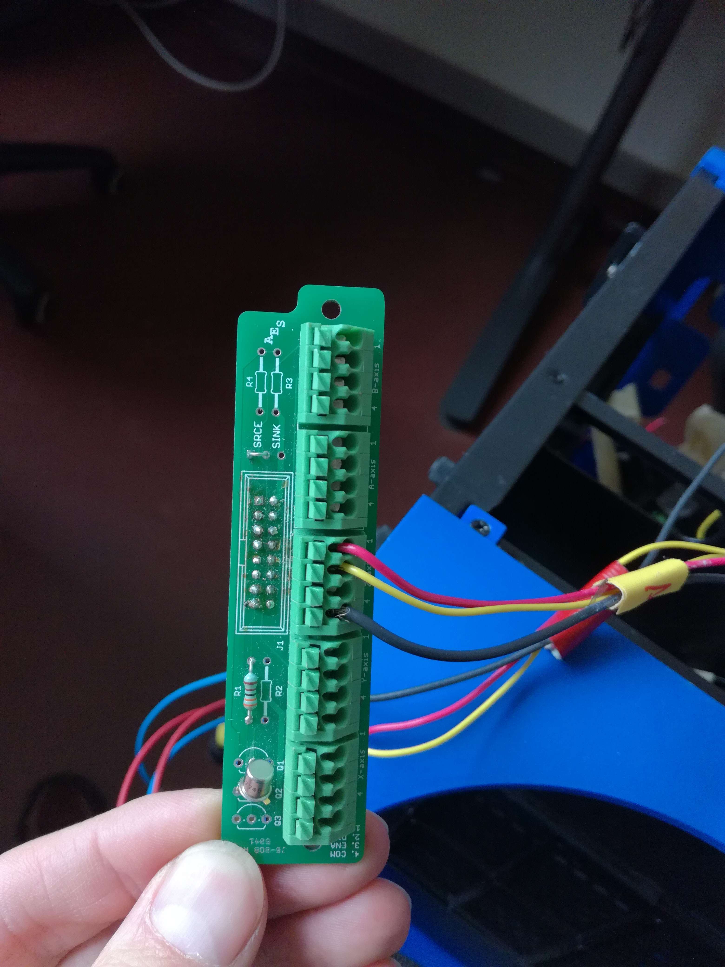
J5Bob/J5-Bob_source-enable_assembly_for_COSI-Measure.jpg
