MatthewBeddows/COSI-Electronics/Manuals, Datasheets etc/Limit Switches/LJ12A3-4-Z-BX-Inductive-Proximity-Sensor-Switch-Wiring-Diagram.jpg

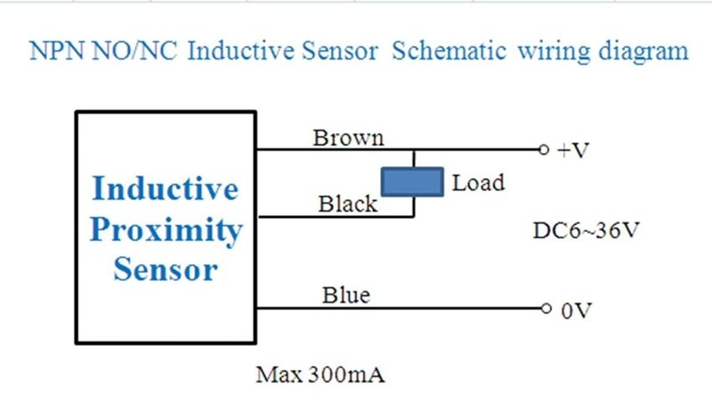
Manuals, Datasheets etc/Limit Switches/LJ12A3-4-Z-BX-Inductive-Proximity-Sensor-Switch-Wiring-Diagram.jpg
