MatthewBeddows/COSI-Electronics/Power management board/assembled_board_bottom.jpg

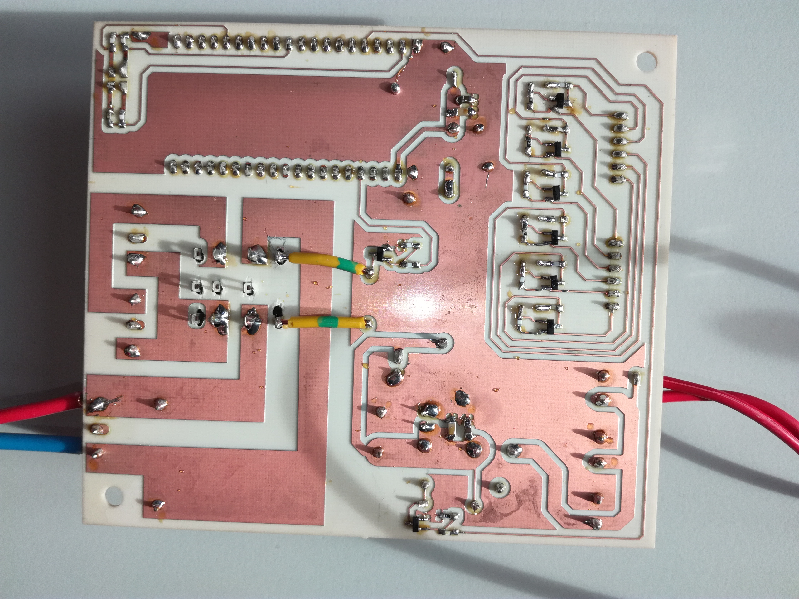
Power management board/assembled_board_bottom.jpg
