MatthewBeddows/COSI-Electronics/J5Bob/FromGithub/doc/J5-BOB-SINK-DISABLE.pdf

A

A

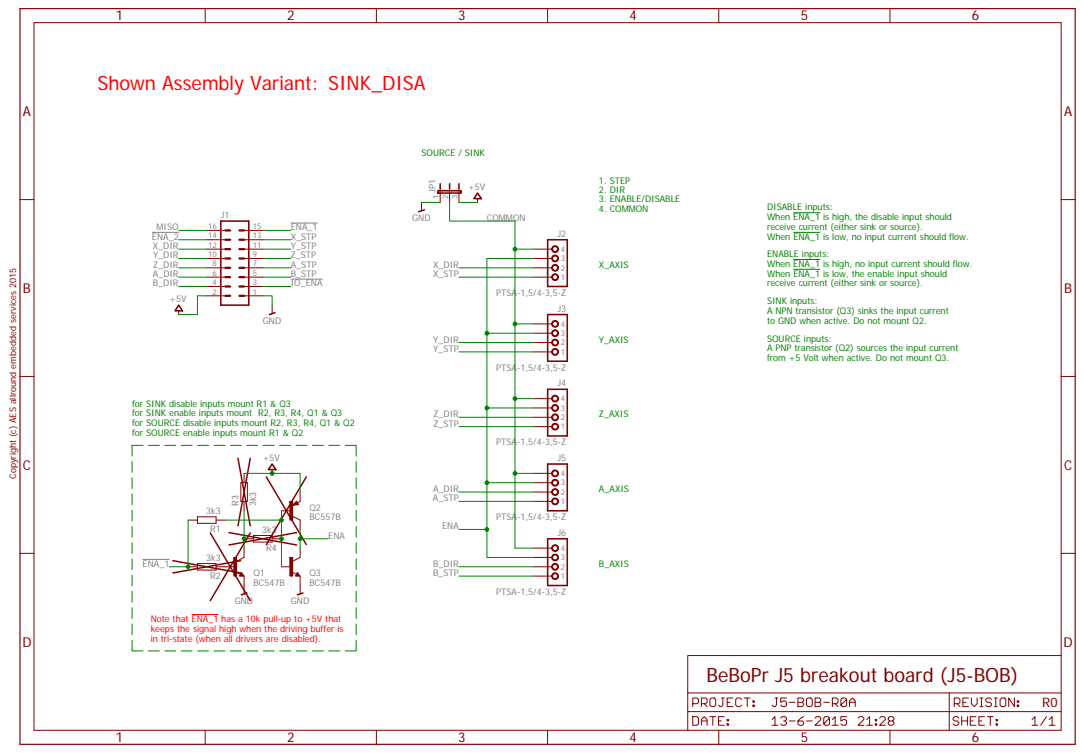
[picture p73: page 1]

DISABLE inputs:
When ENA_1 is high, the disable input should
receive current (either sink or source).
When ENA_1 is low, no input current should flow.
ENABLE inputs:
When ENA_1 is high, no input current should flow.
When ENA_1 is low, the enable input should
SINK inputs:
A NPN transistor (Q3) sinks the input current
to GND when active. Do not mount Q2.
SOURCE inputs:
A PNP transistor (Q2) sources the input current
from +5 Volt when active. Do not mount Q3.

Copyright (c) AES allround embedded services 2015

for SINK disable inputs mount R1 & Q3
for SINK enable inputs mount R2, R3, R4, Q1 & Q3
for SOURCE disable inputs mount R2, R3, R4, Q1 & Q2
for SOURCE enable inputs mount R1 & Q2

Note that ENA_1 has a 10k pull-up to +5V that
keeps the signal high when the driving buffer is
in tri-state (when all drivers are disabled).

BeBoPr J5 breakout board (J5-BOB)
