MatthewBeddows/COSI-Electronics/Power management board/cosi_pwr.kicad_pcb

## KiCad design Power management board/cosi_pwr.kicad_pcb (2025-01-15)

Schematic: cosi_pwr.sch

Parts:
C1, C5: 100u; CPOL-RADIAL-100UF-25V
C2, C6: 4.7u; C_0805_HandSoldering
C3, C7: 0.1u; C_0805_HandSoldering
D1, D2: 1N4004; DO41-10
IO1, IO2: 1X20
JP1: 2X02
JP2, JP3: 1X06
K1: PT371512; PT-3
K2: G5SB
L1: MESC-120M-01
R1, R5, R9: 1k; R0603
R2, R6, R7, R8, R11, R12, R13, R14, R15, R16, R17, R18, R19, R20, R21, R22: 10k; R0603
R10: 1k; R_0805_HandSoldering
U1: IRM_15_20
U2: DCDC_SIM1_DIP8
U3, U5, U6, U7, U8, U9, U10, U11: N-CHANNEL-MOSFET-BSS138; SOT-23_Handsoldering
X1, X2, X3: AK500_3
X4, X5, X6: AK500_2

Connections:
+3V3: IO2.19, R9.2, R10.2
+5V: C6.1, C7.1, IO1.19, R7.2, R11.2, R13.2, R15.2, R17.2, R19.2, U2.5, U6.1, U7.1, U8.1, U9.1, U10.1, U11.1
+12V: C1.1, C2.1, C3.1, C5.1, D2.C, K2.1, K2.2, L1.P$1, U1.V+
/+1.8V: IO2.18
/AC_L: K1.31, U1.AC/L, X1.1
/AC_N: K1.11, U1.AC/N, X1.3
/BANK1_0: IO2.1
/BANK1_1: IO2.2
/BANK1_2: IO2.3
/BANK1_3: IO2.4
/BANK1_4: IO2.5, JP1.4, R21.2
/BANK1_5: IO2.6
/BANK1_6: IO2.7
/BANK1_7: IO2.8
/BANK1_8: IO2.9
/BANK1_9: IO2.10, JP1.2, R22.2
/BANK1_10: IO2.11
/BANK1_11: IO2.12
/BANK1_12: IO2.13
/BANK1_13: IO2.14
/BANK1_14: IO2.15
/BANK1_15: IO2.16, R5.1
/BANK1_VCC: IO2.17
/BANK2_0: IO1.1
/BANK2_1: IO1.2
/BANK2_2: IO1.3
/BANK2_3: IO1.4
/BANK2_4: IO1.5
/BANK2_5: IO1.6
/BANK2_6: IO1.7
/BANK2_7: IO1.8
/BANK2_8: IO1.9
/BANK2_9: IO1.10
/BANK2_10: IO1.11
/BANK2_11: IO1.12
/BANK2_12: IO1.13
/BANK2_13: IO1.14
/BANK2_14: IO1.15
/BANK2_15: IO1.16, R1.1
/BANK2_16: IO1.17
/BANK2_VCC: IO1.18
/N$1: R1.2, R2.2, U3.1
/N$2: D1.A, K1.A2 (2), U3.3
/N$4: L1.P$2, U2.4
/N$14: R5.2, R6.2, U5.1
/N$15: D2.A, K2.5, U5.3
/N$19: JP1.1, R9.1
/N$20: JP1.3, R10.1
/SW_X+_H: JP3.1, R12.1, U7.3
/SW_X+_L: JP2.1, R11.1, U7.2
/SW_X-_H: JP3.2, R14.1, U8.3
/SW_X-_L: JP2.2, R13.1, U8.2
/SW_Y+_H: JP3.3, R8.1, U6.3
/SW_Y+_L: JP2.3, R7.1, U6.2
/SW_Y-_H: JP3.4, R16.1, U9.3
/SW_Y-_L: JP2.4, R15.1, U9.2
/SW_Z+_H: JP3.5, R18.1, U10.3
/SW_Z+_L: JP2.5, R17.1, U10.2
/SW_Z-_H: JP3.6, R20.1, U11.3
/SW_Z-_L: JP2.6, R19.1, U11.2
GND: C1.2, C2.2, C3.2, C5.2, C6.2, C7.2, IO1.20, IO2.20, R2.1, R6.1, R21.1, R22.1, U1.V-, U2.1, U2.7, U3.2, U5.2, X4.2, X5.2, X6.2
unnamed: K1.14 (S), X2.3, X3.3
unnamed: K1.34 (S), X2.1, X3.1
PE: X1.2, X2.2, X3.2
VCC_+12V: D1.C, K1.A1 (1), K2.3, R8.2, R12.2, R14.2, R16.2, R18.2, R20.2, X4.1, X5.1, X6.1

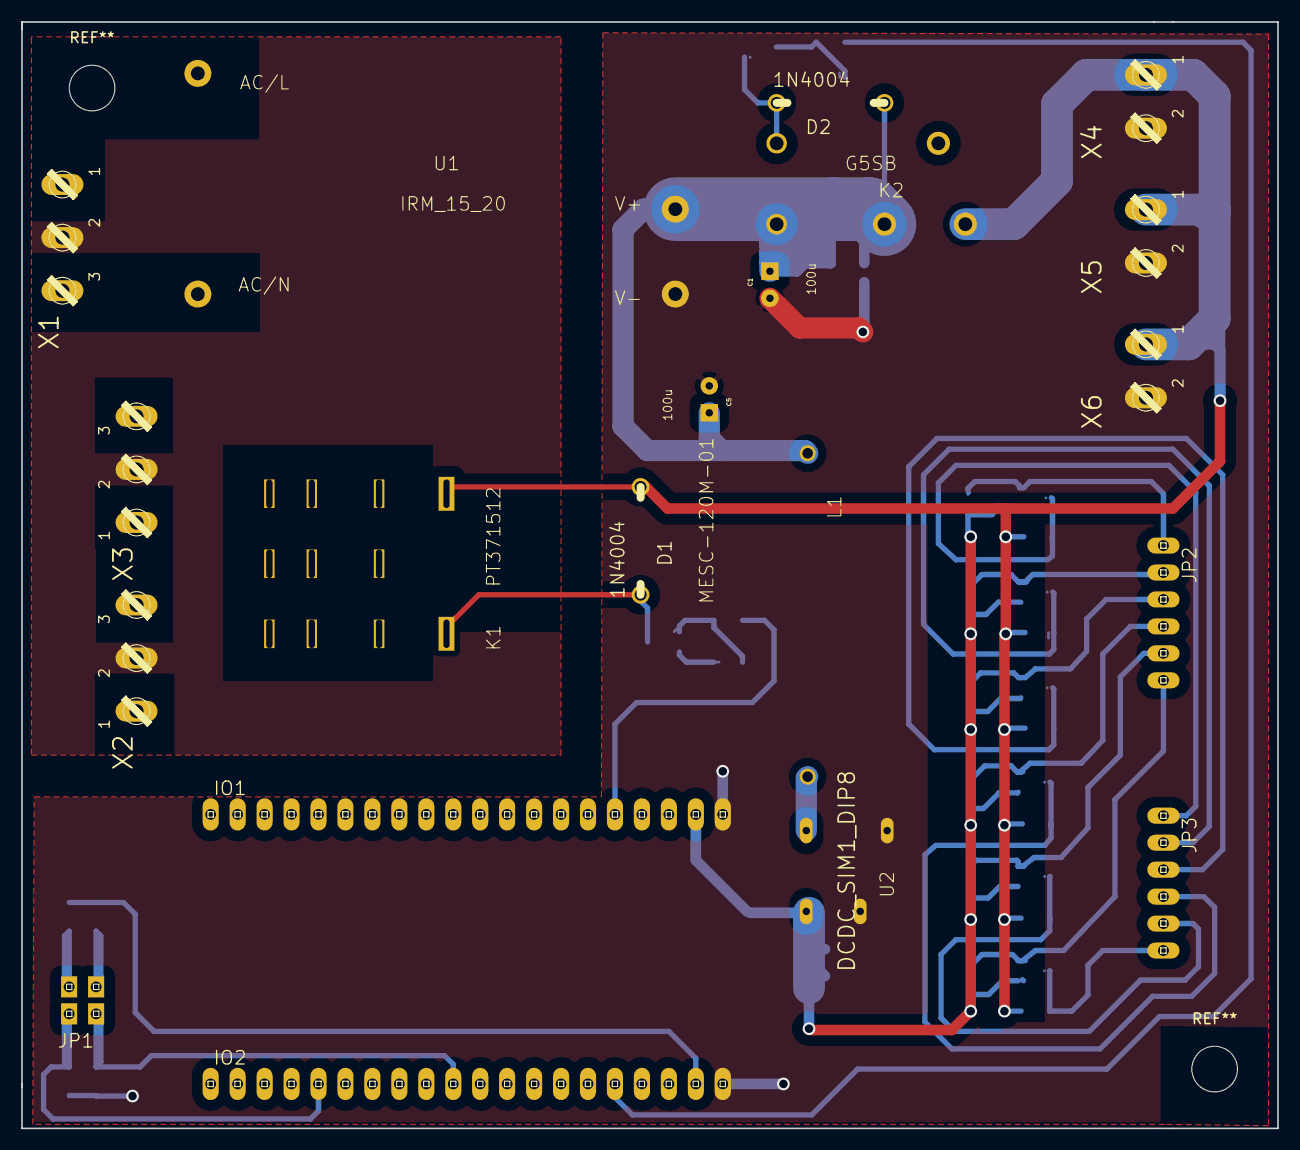
[picture p74: board cosi_pwr.kicad_pcb from above]

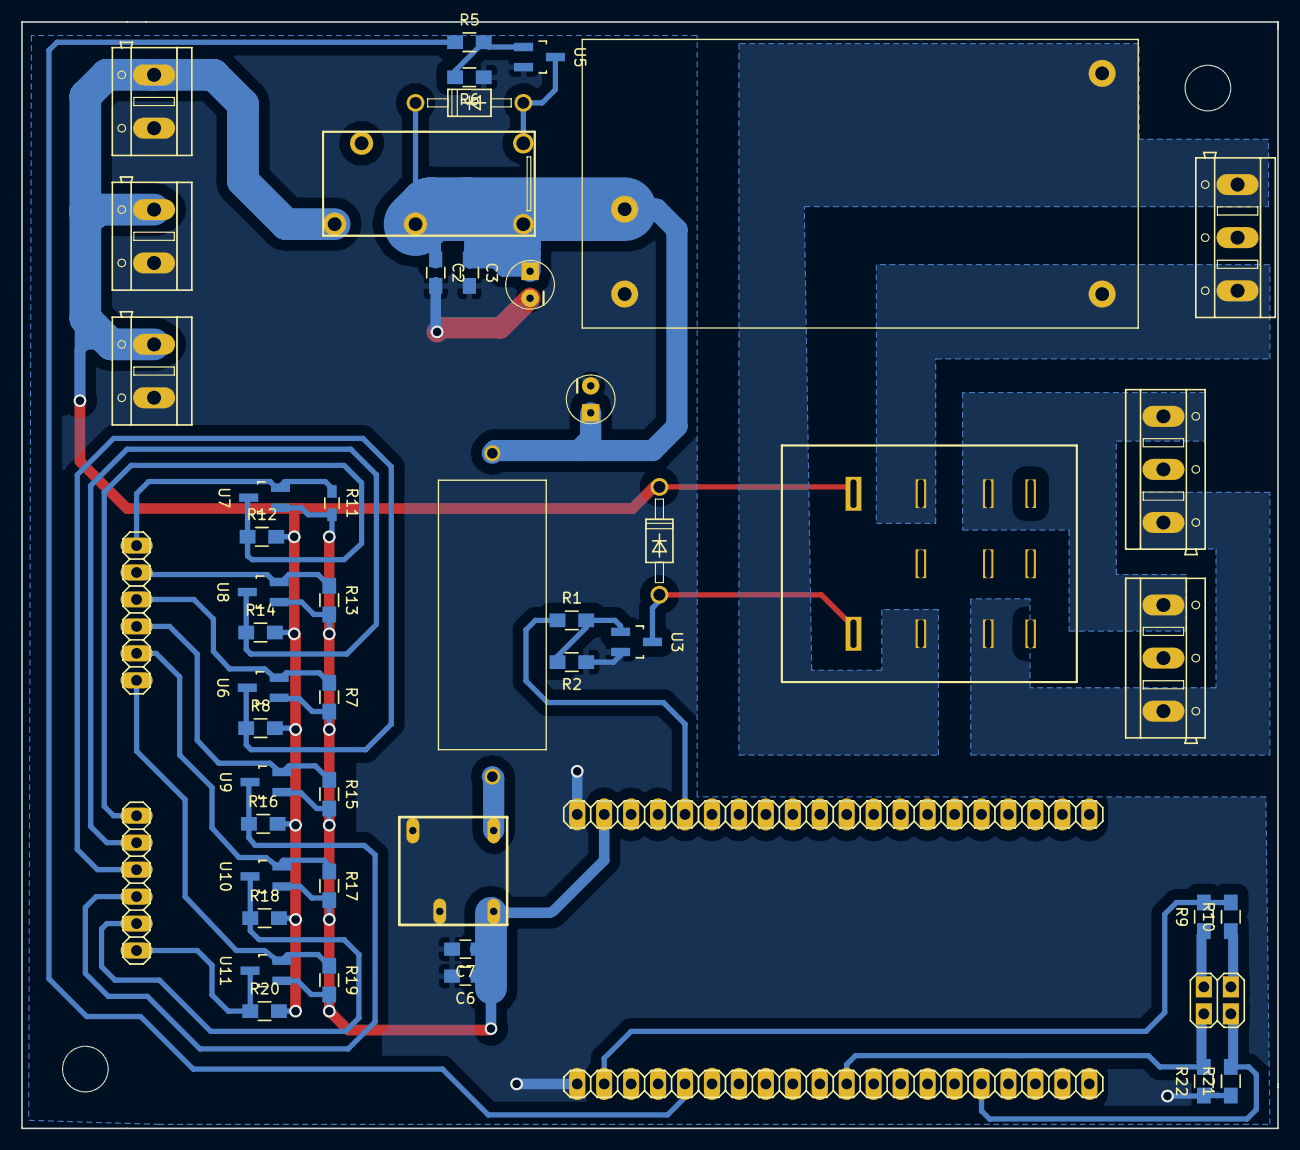
[picture p75: board cosi_pwr.kicad_pcb from below]

Board: 2 copper layers, 118.4 x 104.3 mm, 52 parts (32 on the bottom side), 33 nets.
