MatthewBeddows/COSI-Electronics/(commit log)

2024-10-09 Initialising the repo
    Direct copy from the initial COSI repo
    [2018-11-11_cosi-measure-v1.0_casing.FCStd, 2019-03-04_cosi-measure_v1.0_BoM_electronics.ods, casing_assembled_withMountingParts.stl, casing_assembled_withoutMountingParts.stl, cosi_pwr-2019-01-25-09-19-00.sch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]
2024-10-09 Copied the content of the assembly instructions
    Using version 1.0 of the COSI system as it is the one we ordered.
2025-01-15 modifications of assembly instructions
2025-01-15 Adding info for electronics and casing design
    [casing_assembled_withMountingParts.stl, cosi_pwr.kicad_pcb]
2025-09-08 Added test RA
    Test Risk assessment added.
    [RiskAssessment.csv]
2025-09-12 Added test BOM
